AutoFAB-dev/Robot-Hardware/docs/README.md

# Docs

## Set up your cell
1. [What's in the box](setup/01-whats-in-the-box.md)
2. [Unbox and check for damage](setup/02-unboxing-and-damage-checks.md)
3. [Mount the arm and rail](setup/03-mounting-arm-and-rail.md)
4. [Wiring, power, stop and cameras](setup/04-wiring-power-stop-cameras.md)
5. [Flash, install, remote access](setup/05-flash-install-remote-access.md)
6. [Link your printer](setup/06-link-your-printer.md)
   Then [calibrate the cell](calibration/) (IDs are local; homing is after SSH, before the ready check)
7. [Ready check and handover](setup/07-ready-check-and-handover.md)

If something goes wrong: [Troubleshooting](troubleshooting.md) · [Getting help](getting-help.md)

## Calibration
[Index](calibration/) · [Servo IDs and homing](calibration/servo-ids-and-homing.md) · [Arm calibration files](calibration/arm-calibration-files.md) · [Rail homing](calibration/rail-homing.md) · [Cameras](calibration/cameras.md) · [Printer and bed](calibration/printer-and-bed.md)

## Reference
[Safety](reference/safety.md) · [Arm](reference/arm/) · [Rail](reference/rail/) · [Controller](reference/controller/) · [Cameras](reference/cameras/) · [printable files](../hardware/) · [all reference](reference/)
