AutoFAB-dev/Robot-Hardware/cad/README.md

# CAD and printable files

The full printable set now lives under [`hardware/`](../hardware/) (one folder per component, each with a part-by-part table).

| Folder | Contents | Licence |
|---|---|---|
| [`elrobot/`](elrobot/) | Earlier copies of the three ElRobot gripper camera-mount STLs and the basic 3MF | Apache-2.0, NormaCore |
| [`../hardware/arm/follower/`](../hardware/arm/follower/) | ElRobot follower STL / STEP / 3MF | Apache-2.0, NormaCore |
| [`../hardware/rail/`](../hardware/rail/) | leslider 3MF | Apache-2.0, Pham Tuan Binh |
| [`../hardware/controller/`](../hardware/controller/) | ElRobot driver enclosures | Apache-2.0, NormaCore |
| [`../hardware/cameras/`](../hardware/cameras/) | ElRobot gripper camera mounts | Apache-2.0, NormaCore |

- TODO: an AutoFAB base adapter that fits ElRobot on leslider's carriage (leslider's base mount is designed for the SO-101).
- TODO: calibration fiducial tile and holder files.
