AutoFAB-dev/Robot-Hardware/firmware/README.md

# Servo notes
Hardware-level IDs and wiring live with each component: [arm](../docs/reference/arm/), [rail](../docs/reference/rail/), [controller](../docs/reference/controller/), [cameras](../docs/reference/cameras/). Customer path: [step 4](../docs/setup/04-wiring-power-stop-cameras.md).
