AutoFAB-dev/Robot-Hardware/images/README.md

# Images
TODO: add photos and diagrams for each setup step:
- [ ] 01 parts laid out and labelled
- [ ] 02 open box, arm supported, damage checks
- [ ] 03 rail clamped next to a printer
- [ ] 04 wiring: stop, two supplies, hub, cameras
- [ ] 05 setup Wi-Fi and claim screen
- [ ] 06 printer added in the app
- [ ] 07 ready-check ticks
- [ ] DIY: arm build stages, pinion mesh, wrist-camera mount, driver enclosure

Licence: CC-BY-4.0 unless noted. Remove faces, serial numbers, network names and claim codes before committing.
