AutoFAB-dev/Robot-Hardware/hardware/arm/README.md

# Arm hardware

ElRobot **follower** only. Files and the part-by-part table: [follower/](follower/).

Upstream: https://github.com/norma-core/norma-core/tree/main/hardware/elrobot  
Commit: `0d17bb300d712eeb5437d41ddb95ce380b5384e6`  
Licence: Apache-2.0 ([follower/LICENSE](follower/LICENSE)). Copyright NormaCore.

Docs: [arm reference](../../docs/reference/arm/).
