AutoFAB-dev/Robot-Hardware/hardware/rail/README.md

# Rail hardware

leslider printed parts used on this cell. Unmodified copies from [leslider / Pham Tuan Binh](https://github.com/pham-tuan-binh/leslider) (Apache-2.0). Upstream file names are unchanged.

- **Upstream commit:** `a7c5c86669f7452e60e764f14ab0bff406213e3d`
- **Licence:** [LICENSE](LICENSE) (Apache-2.0). Copyright Pham Tuan Binh.

Print defaults: **TODO**. leslider does not state filament, nozzle, layer height, infill, or orientation. Do not assume the ElRobot PLA / 0.4 mm / 0.2 mm defaults.

Onshape source is linked from the [leslider README](https://github.com/pham-tuan-binh/leslider#2-3d-printed-parts). The `3d/onshape.png` preview is not a part file and is not copied.

The ElRobot-to-carriage adapter is AutoFAB and is **TODO**.

Docs: [rail reference](../../docs/reference/rail/).

## Printed parts

| File | Qty | Material | Print settings | Notes |
|---|---|---|---|---|
| [3d/separate_components/leg.3mf](3d/separate_components/leg.3mf) | 2 | TODO | TODO | One at each end of the 2020 |
| [3d/separate_components/base_mount.3mf](3d/separate_components/base_mount.3mf) | 1 | TODO | TODO | Designed for the SO-101 base, not ElRobot |
| [3d/separate_components/pinion.3mf](3d/separate_components/pinion.3mf) | 1 | TODO | TODO | Press-fits on the rail servo output gear |
| [3d/separate_components/track.3mf](3d/separate_components/track.3mf) | as needed | TODO | TODO | 20 mm rack segments; print enough to span the extrusion and trim the last if it overruns |
| [3d/full_print.3mf](3d/full_print.3mf) | 1 plate | TODO | TODO | All-in-one plate (legs, base mount, pinion, track) |
| ElRobot-to-carriage adapter | 1 | TODO | TODO | File **TODO** |
