AutoFAB-dev/Robot-Hardware/cad/elrobot/README.md

# ElRobot files (third-party)
These files are unmodified copies from the ElRobot follower arm by NormaCore:
https://github.com/norma-core/norma-core/tree/main/hardware/elrobot
They're licensed under **Apache-2.0** (see `LICENSE` in this folder). Copyright NormaCore.

The full follower set, including these same camera-mount files, is now in [`hardware/`](../../hardware/). This folder keeps the earlier copies.

| File | Upstream path |
|---|---|
| stl/CameraMount_square_27mm.stl, _34mm, _regular | hardware/elrobot/STL/gripper_camera_mounts/ |
| 3mf/gripper_camera_mounts_basic.3mf | hardware/elrobot/print/basic/ |

Printed-part lists: [arm parts](../../docs/reference/arm/parts.md), [cameras parts](../../docs/reference/cameras/parts.md).
