AutoFAB-dev/Robot-Hardware/docs/reference/arm/README.md

# Arm

ElRobot follower: seven joints plus a gripper. Reach **430 mm**, **7+1 DOF**, from the ElRobot README.

Credit: [ElRobot](https://github.com/norma-core/norma-core/tree/main/hardware/elrobot) by NormaCore (Apache-2.0), including the [follower assembly manual](https://github.com/norma-core/norma-core/blob/main/hardware/elrobot/manual-follower.pdf). Values not stated there are **TODO**.

Same pages as the other components:

- [Parts](parts.md)
- [Wiring and IDs](wiring.md) · [IDs](ids.md)
- [Assembly](assembly.md)
- [Checks](checks.md)

See also: [rail](../rail/), [controller](../controller/), [cameras](../cameras/). Customer path: [Set up your cell](../../setup/01-whats-in-the-box.md).
