AutoFAB-dev/Robot-Hardware/docs/reference/cameras/README.md

# Cameras

Wrist camera on the gripper, scene camera on the cell, and their mounts. The powered USB hub sits here because ElRobot requires it **primarily for the cameras**.

Credit: wrist camera, three gripper mounts, and hub notes from [ElRobot](https://github.com/norma-core/norma-core/tree/main/hardware/elrobot) by NormaCore (Apache-2.0), including the [follower assembly manual](https://github.com/norma-core/norma-core/blob/main/hardware/elrobot/manual-follower.pdf) steps 65–75 and the README “Camera Mounts” / “USB Hub & Power Distribution” sections. Scene camera examples from the ElRobot BOM (“Table Camera”) and the [cell parts list](../../../bom/BOM.md). Files: [hardware/cameras/](../../../hardware/cameras/). Values not stated there are **TODO**.

Same pages as the other components:

- [Parts](parts.md)
- [Wiring and IDs](wiring.md) · [IDs](ids.md)
- [Assembly](assembly.md)
- [Checks](checks.md)

See also: [arm](../arm/), [rail](../rail/), [controller](../controller/). Customer path: [Set up your cell](../../setup/01-whats-in-the-box.md).
