AutoFAB-dev/Robot-Hardware/docs/reference/controller/README.md

# Controller

Raspberry Pi, servo bus adapter, power supplies, and the physical stop. This is the box that powers the arm and rail buses and runs the closed AutoFAB image.

Credit: driver, 12 V barrel, and USB-is-data-only notes from the ElRobot [README](https://github.com/norma-core/norma-core/blob/main/hardware/elrobot/README.md) (BOM and “Hardware & Design Notes”) and the [follower assembly manual](https://github.com/norma-core/norma-core/blob/main/hardware/elrobot/manual-follower.pdf) (step 2 enclosure, steps 3–4 ID setup). Pi model and 27 W USB-C from the [cell parts list](../../../bom/BOM.md). Raspberry Pi power: [Raspberry Pi documentation](https://www.raspberrypi.com/documentation/). Values not stated there are **TODO**.

Same pages as the other components:

- [Parts](parts.md)
- [Wiring and IDs](wiring.md) · [IDs](ids.md)
- [Assembly](assembly.md)
- [Checks](checks.md)

See also: [arm](../arm/), [rail](../rail/), [cameras](../cameras/). Customer path: [Set up your cell](../../setup/01-whats-in-the-box.md).
