AutoFAB-dev/Robot-Hardware/docs/reference/rail/README.md

# Rail

leslider-style 2020 V-slot rack rail, plus the adapter that puts the ElRobot base on the carriage.

Credit: [leslider](https://github.com/pham-tuan-binh/leslider) by Pham Tuan Binh (Apache-2.0), including the [BOM, printed parts, and assembly](https://github.com/pham-tuan-binh/leslider#1-bill-of-materials). The ElRobot-to-carriage adapter is AutoFAB and is **TODO**. Values not stated upstream are **TODO**.

Same pages as the other components:

- [Parts](parts.md)
- [Wiring and IDs](wiring.md) · [IDs](ids.md)
- [Assembly](assembly.md)
- [Checks](checks.md)

See also: [arm](../arm/), [controller](../controller/), [cameras](../cameras/). Customer path: [Set up your cell](../../setup/01-whats-in-the-box.md).
