AutoFAB-dev/Robot-Hardware/docs/getting-help.md

# Getting help

This repo is the self-service guide for putting the cell next to your printers and handing it to AutoFAB. AutoFAB software is closed source.

**Safety:** If the stop fails or the arm moves when it should not, unplug 12 V and [report it privately](../SECURITY.md). That is a safety issue, not a public bug thread.

## AutoFAB (the service)
For the managed service or a setup password, email [info@autofab.net](mailto:info@autofab.net).

## This hardware guide
- Walk the numbered path from [Set up your cell](setup/01-whats-in-the-box.md).
- Check [Troubleshooting](troubleshooting.md).
- Open a GitHub **issue** if a step in this guide is wrong. Never post passwords, setup-card details, claim codes, tokens, or photos that show them.

## Security and conduct
- Security: [SECURITY.md](../SECURITY.md)
- Conduct: [CODE_OF_CONDUCT.md](../CODE_OF_CONDUCT.md)
