AutoFAB-dev/Robot-Hardware/docs/reference/arm/checks.md

# Arm — checks

Credit: rotation and seating notes from the ElRobot follower manual (full rotation after each horn; jaws even; footprints clean).

**TODO image:** arm supported, every joint moved by hand, gripper jaws even

With **12 V off**:

- [ ] Each servo 1–8 is labelled and matches [IDs](ids.md)
- [ ] Every joint turns through the range the manual calls “full rotation”
- [ ] Gripper jaws move evenly; gear is fully seated
- [ ] No cable snags; slack at every joint
- [ ] Shields do not bind the joints
- [ ] Arm is supported so it cannot slam down

Do not command motion from software for these checks. Powered checks are done with AutoFAB after handover.
