AutoFAB-dev/Robot-Hardware/docs/reference/arm/ids.md

# Arm — IDs

Credit: IDs **1–8** and “label each servo 1 to 8” from the ElRobot [follower assembly manual](https://github.com/norma-core/norma-core/blob/main/hardware/elrobot/manual-follower.pdf) (steps 3–4 and each joint).

Set IDs **one servo at a time**. Label each servo before you install it. **TODO:** ElRobot says “Set Servo ids using app” and does not name the app.

| ID | Where it goes (ElRobot manual) |
|---|---|
| 1 | Base |
| 2 | Joint 1 |
| 3 | Joint 2 |
| 4 | Joint 3 |
| 5 | Joint 4 |
| 6 | Joint 5 |
| 7 | Joint 6 |
| 8 | Gripper |

Rail drive is **ID 9**: [rail IDs](../rail/ids.md). Do not use leslider's SO-101 slider ID 7 on this arm.
