AutoFAB-dev/Robot-Hardware/docs/reference/rail/checks.md

# Rail — checks

Credit: carriage travel and pinion mesh from leslider assembly plus the customer mount step. Click / jump notes match [troubleshooting](../../troubleshooting.md).

**TODO image:** rail clamped, carriage rolled by hand the full length, pinion on the rack

With **12 V off**:

- [ ] Rail servo is labelled **9** and matches [IDs](ids.md) (not leslider’s SO-101 ID 7)
- [ ] Track segments sit in the top channel and span the extrusion
- [ ] Gantry V-wheels are in the side channels; the plate was fitted before the legs
- [ ] Both legs are bolted (M5 into drop-in T-nuts)
- [ ] Base mount is on the gantry (two M5, 20 mm spacing)
- [ ] ElRobot adapter is fitted — file and fasteners still **TODO**; do not leave the SO-101 base mount standing in for ElRobot
- [ ] Pinion is on the output gear and engaged with the rack
- [ ] Carriage rolls the full length by hand. If it clicks or jumps, the pinion is not meshed
- [ ] Bus cable is after the gripper; slack loop along the rail; no snags

Do not command motion from software for these checks. Powered checks are done with AutoFAB after handover.
