AutoFAB-dev/Robot-Hardware/hardware/rail/3d/full_print.3mf

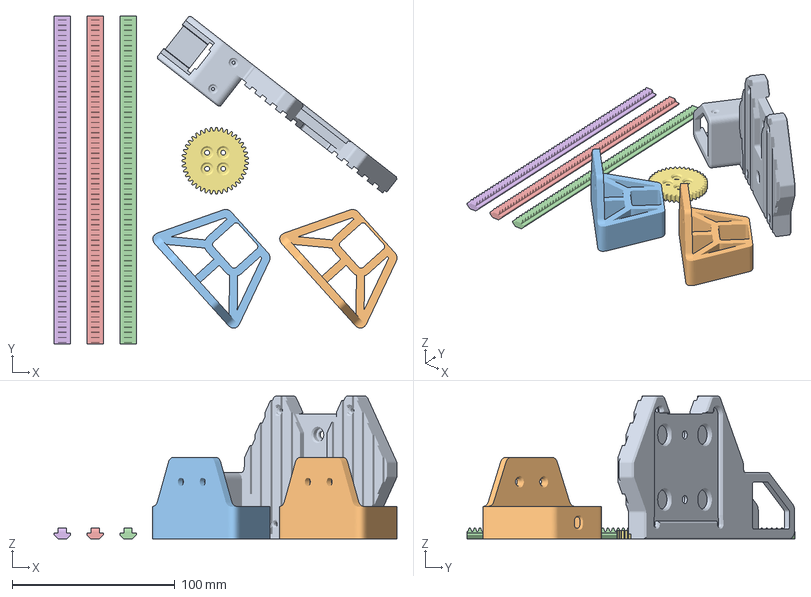
[picture p1: CAD file, 2026-10-17]
hardware/rail/3d/full_print.3mf
210.5 x 201.1 x 87.6 mm
Base Mount
Leg x 2
Track x 3
Pinion
