AutoFAB-dev/Robot-Hardware/cad/elrobot/3mf/gripper_camera_mounts_basic.3mf

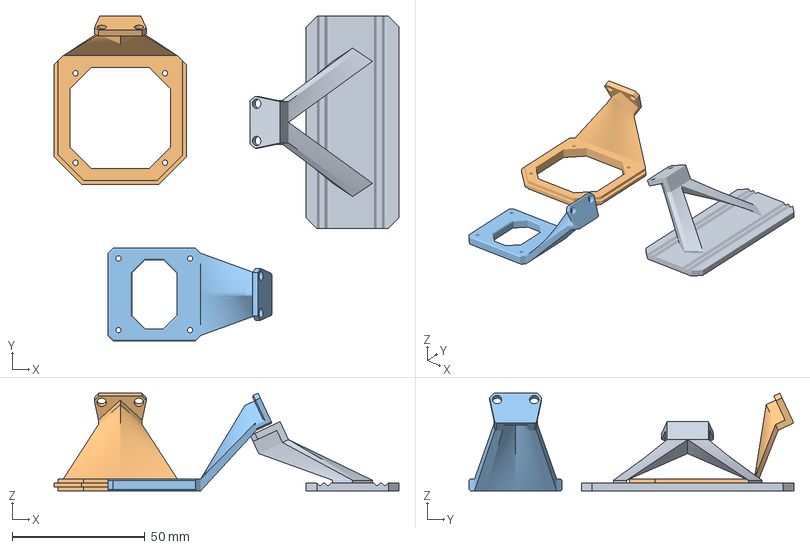
[picture p2: CAD file, 2026-10-17]
cad/elrobot/3mf/gripper_camera_mounts_basic.3mf
130.1 x 122.4 x 36.8 mm
CameraMount_regular.stl
CameraMount_square_34mm.stl
CameraMount_square_27mm.stl
