AutoFAB-dev/Robot-Hardware/cad/elrobot/stl/CameraMount_square_34mm.stl

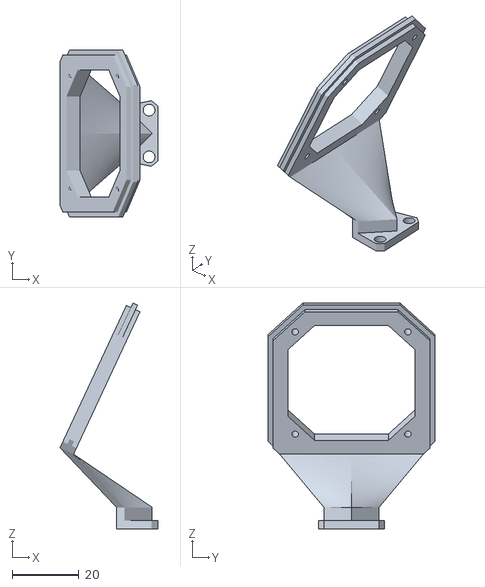
[picture p3: CAD file, 2026-10-17]
cad/elrobot/stl/CameraMount_square_34mm.stl
29.3 x 50.0 x 67.6
