AutoFAB-dev/Robot-Hardware/hardware/arm/follower/print/ams/elrobot_follower_ams.3mf

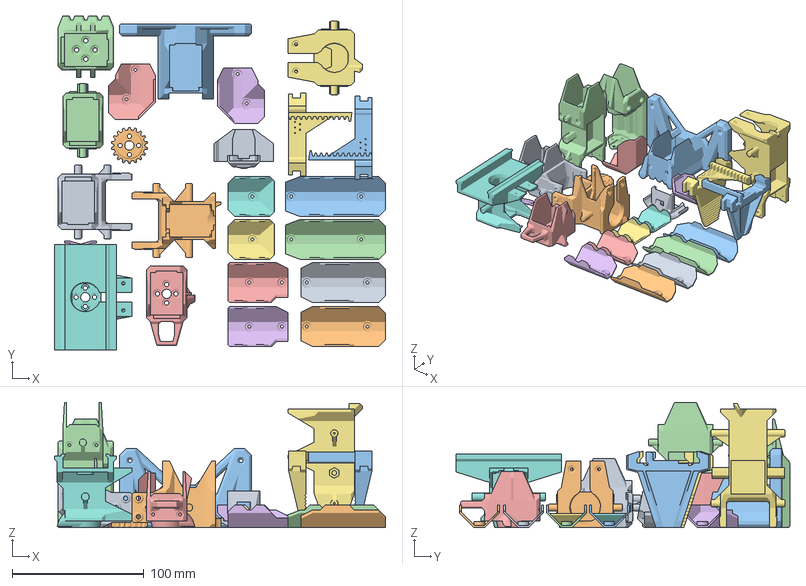
[picture p4: CAD file, 2026-10-17]
hardware/arm/follower/print/ams/elrobot_follower_ams.3mf
251.0 x 253.1 x 95.0 mm
Base Shield.stl
Gripper Gear.stl
Gripper Jaw.stl x 2
Joint 1.stl
Joint 5.stl
Wiring_bracket.stl
Gripper Base.stl
Joint 3.stl
Joint 6.stl
Base.stl
Joint_02.stl
Joint 3 Shield Drive Side.stl
Joint 3 Shield Camera Side.stl
Gripper Base Shield.stl x 2
Joint 2 Shield.stl x 2
Joint 4 Shield.stl x 2
Joint 6 Shield.stl x 2
Joint 4.stl
