AutoFAB-dev/Robot-Hardware/hardware/arm/follower/STEP/elrobot_common_parts/Joint 2.stp

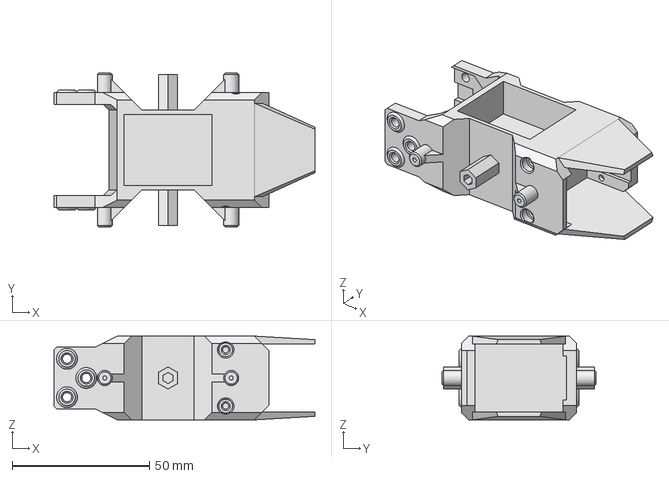
[picture p5: CAD file, 2026-10-17]
hardware/arm/follower/STEP/elrobot_common_parts/Joint 2.stp
95.0 x 56.0 x 30.5 mm
