AutoFAB-dev/Robot-Hardware/hardware/arm/follower/STEP/elrobot_follower_parts/Gripper.stp

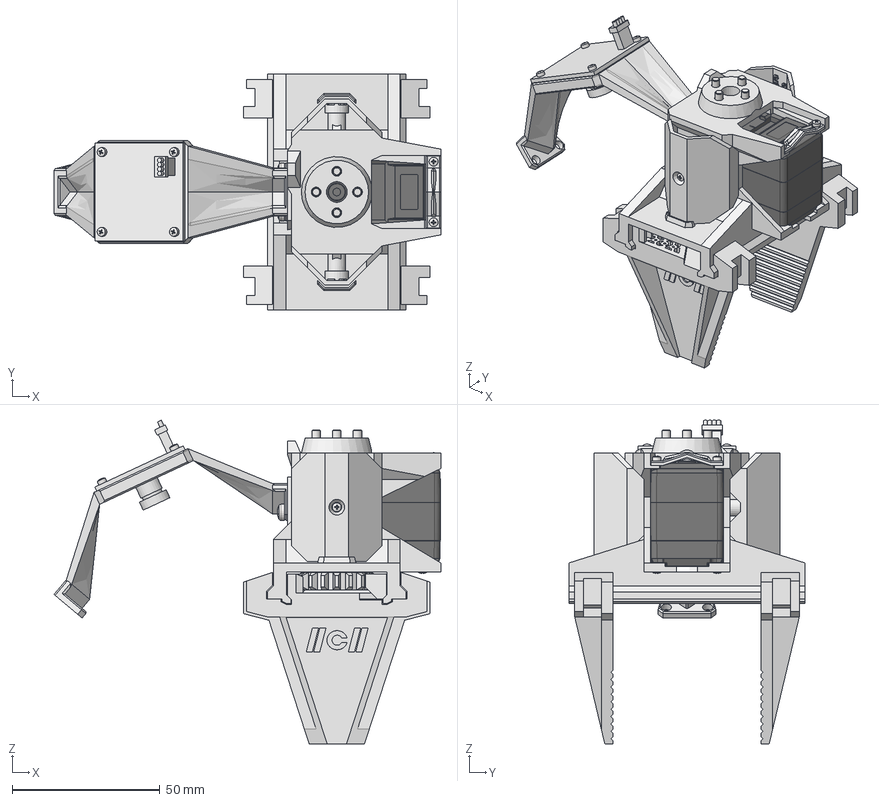
[picture p6: CAD file, 2026-10-17]
hardware/arm/follower/STEP/elrobot_follower_parts/Gripper.stp
130.9 x 80.0 x 109.5 mm
Gripper_Base
Gripper_Gear
Gripper_Jaw x 2
Gripper_Base_Shield_Drive_Side
Gripper_Base_Shield_Camera_Side
CameraMount_square32mm
Wiring_bracket
UVC_Camera
Idler Horn
ZK_122
SG-ZIJI_15
XG-ZIJI_16
MOTOR-1723_3
PCB-CHAZUO_92
GE_27
金属舵盘（驱动）
CRFHTSTATI ANSI B18.6.4 - 1-42 x 3/16 Steel Grade 2 Plain x 10
DIN EN ISO 7045 - M3 x 6 - H Steel 4.6 Plain x 11
