AutoFAB-dev/Robot-Hardware/hardware/arm/follower/STEP/elrobot_follower_parts/individual/Gripper_Base_Shield.stp

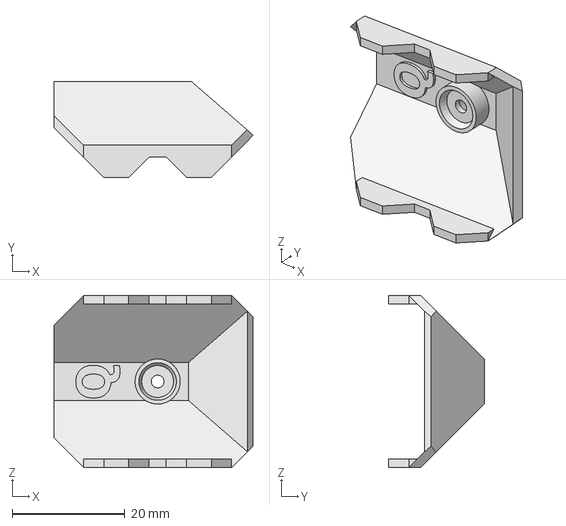
[picture p7: CAD file, 2026-10-17]
hardware/arm/follower/STEP/elrobot_follower_parts/individual/Gripper_Base_Shield.stp
35.3 x 17.0 x 30.5 mm
