AutoFAB-dev/Robot-Hardware/hardware/arm/follower/STL/elrobot_follower/panels.stl

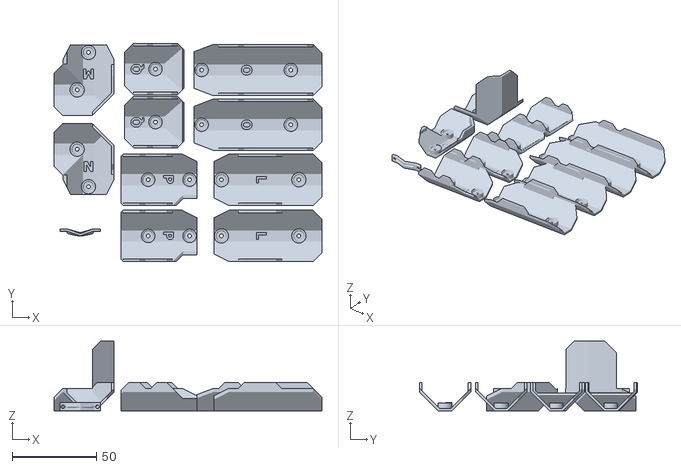
[picture p8: CAD file, 2026-10-17]
hardware/arm/follower/STL/elrobot_follower/panels.stl
159.2 x 129.6 x 41.5
