AutoFAB-dev/Robot-Hardware/hardware/arm/follower/STL/elrobot_individual_parts/elrobot_common_parts/Wiring_bracket.stl

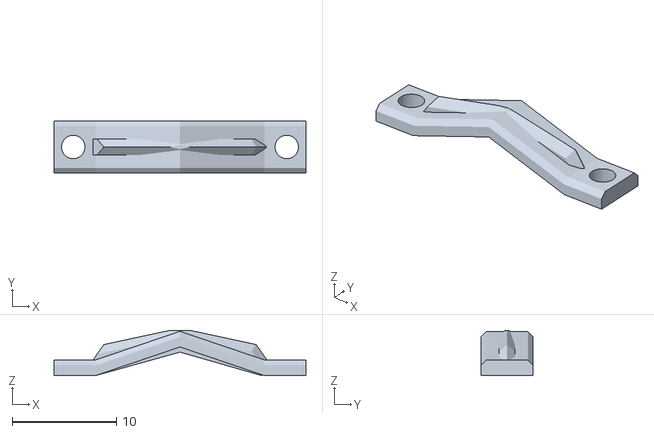
[picture p9: CAD file, 2026-10-17]
hardware/arm/follower/STL/elrobot_individual_parts/elrobot_common_parts/Wiring_bracket.stl
24.2 x 5.00 x 4.33
