AutoFAB-dev/Robot-Hardware/hardware/arm/follower/STL/elrobot_individual_parts/elrobot_follower_parts/Gripper Jaw.stl

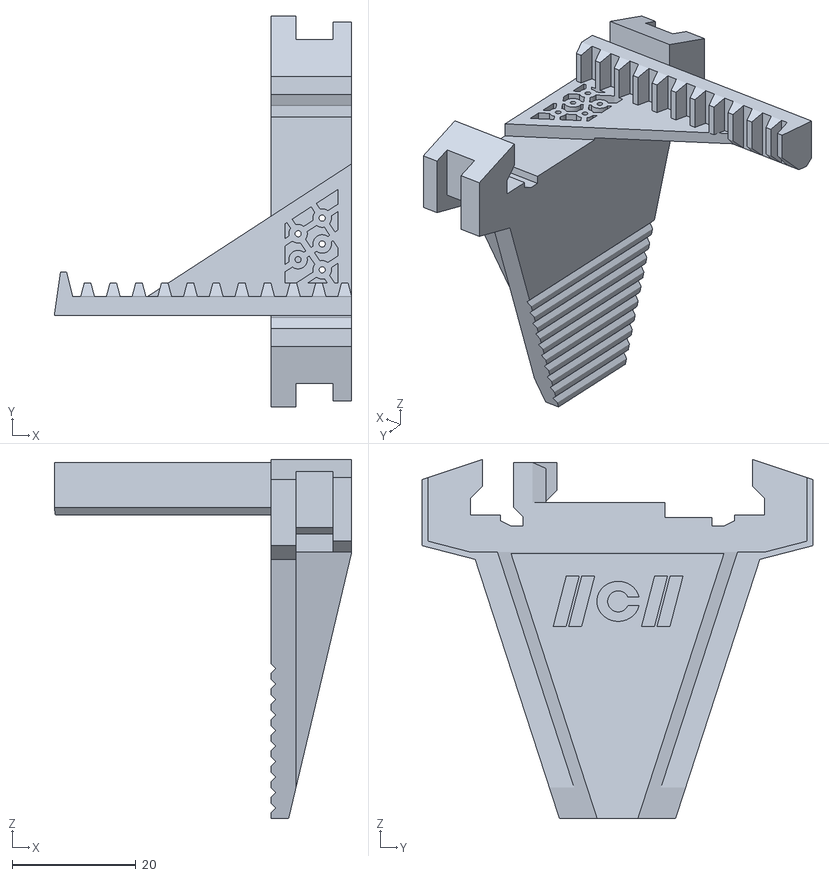
[picture p10: CAD file, 2026-10-17]
hardware/arm/follower/STL/elrobot_individual_parts/elrobot_follower_parts/Gripper Jaw.stl
48.0 x 63.1 x 58.0
