AutoFAB-dev/Robot-Hardware/hardware/controller/print/ams/enclosure_for_waveshare_ams.3mf

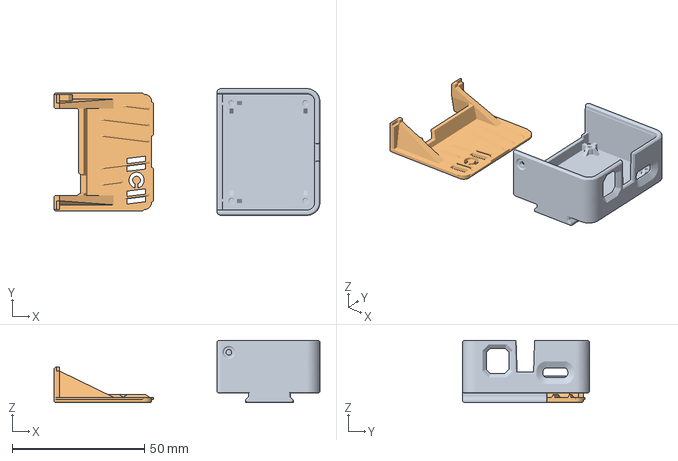
[picture p11: CAD file, 2026-10-17]
hardware/controller/print/ams/enclosure_for_waveshare_ams.3mf
100.7 x 48.0 x 23.5 mm
ws_enclosure_case.stl
ws_enclosure_lid.stl
