AutoFAB-dev/Robot-Hardware/hardware/controller/STEP/case_for_seedstudio/ss_enclosure_case.stp

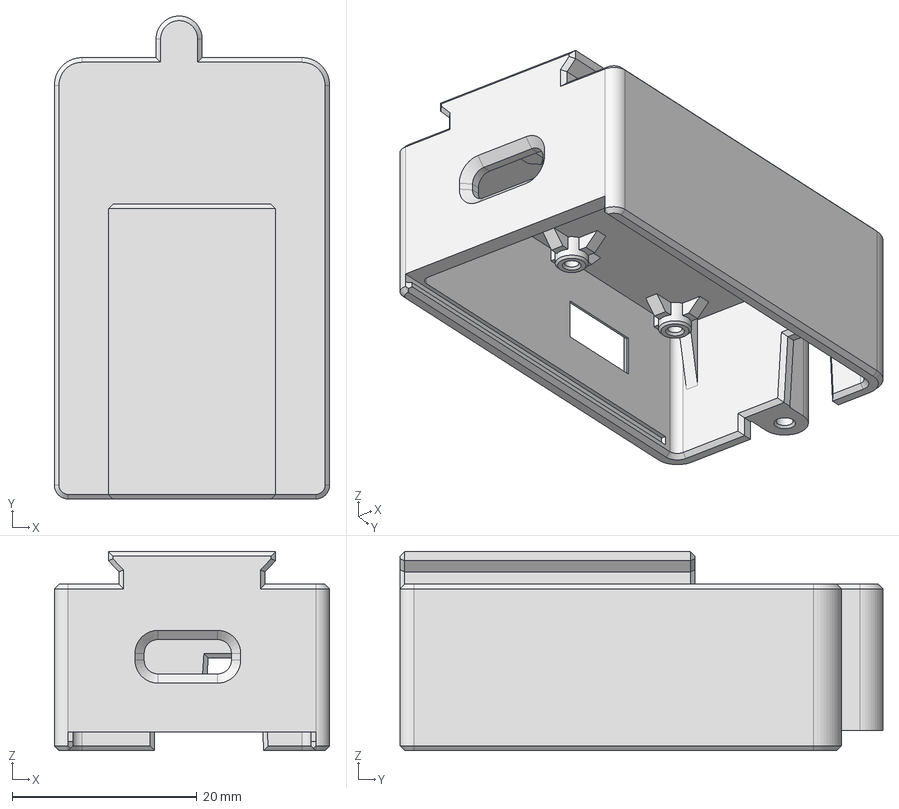
[picture p12: CAD file, 2026-10-17]
hardware/controller/STEP/case_for_seedstudio/ss_enclosure_case.stp
29.8 x 52.3 x 21.5 mm
