AutoFAB-dev/Robot-Hardware/hardware/controller/STEP/case_for_waveshare/ws_enclosure_case.stp

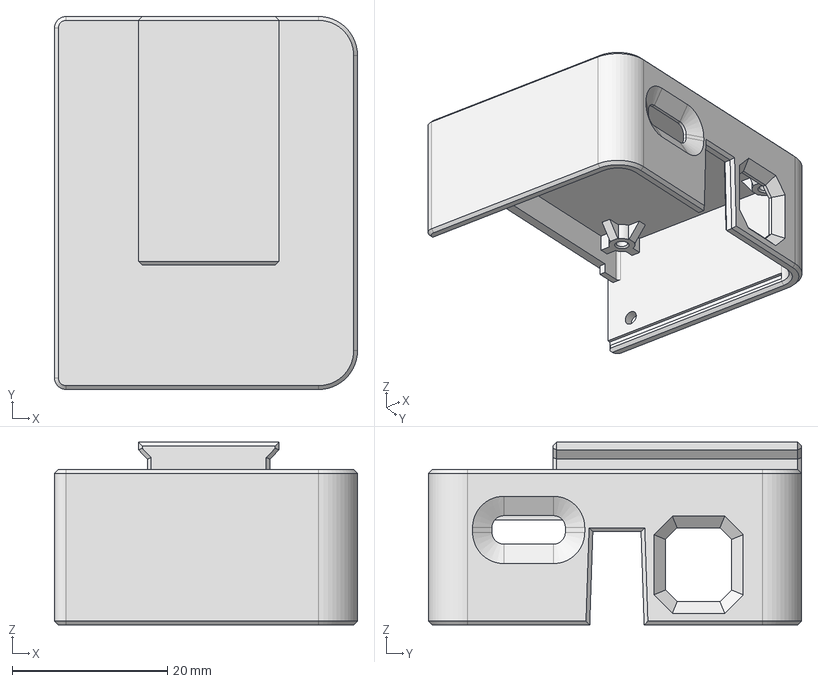
[picture p13: CAD file, 2026-10-17]
hardware/controller/STEP/case_for_waveshare/ws_enclosure_case.stp
39.0 x 48.0 x 23.5 mm
