AutoFAB-dev/Robot-Hardware/hardware/rail/3d/separate_components/track.3mf

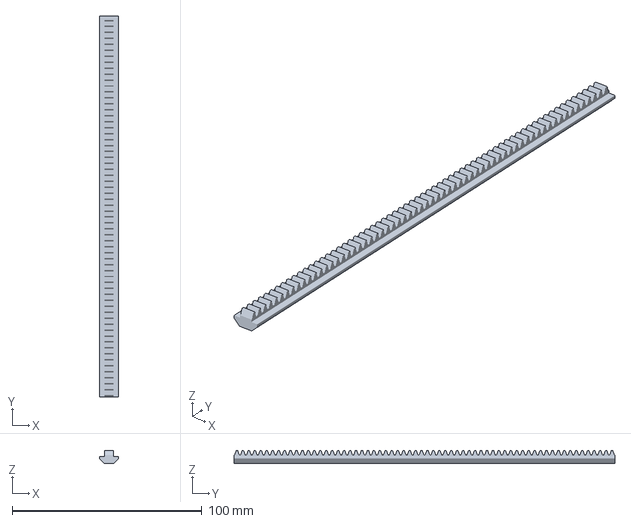
[picture p14: CAD file, 2026-10-17]
hardware/rail/3d/separate_components/track.3mf
10.2 x 201.1 x 6.66 mm
