AutoFAB-dev/Robot-Hardware/cad/elrobot/stl/CameraMount_square_27mm.stl

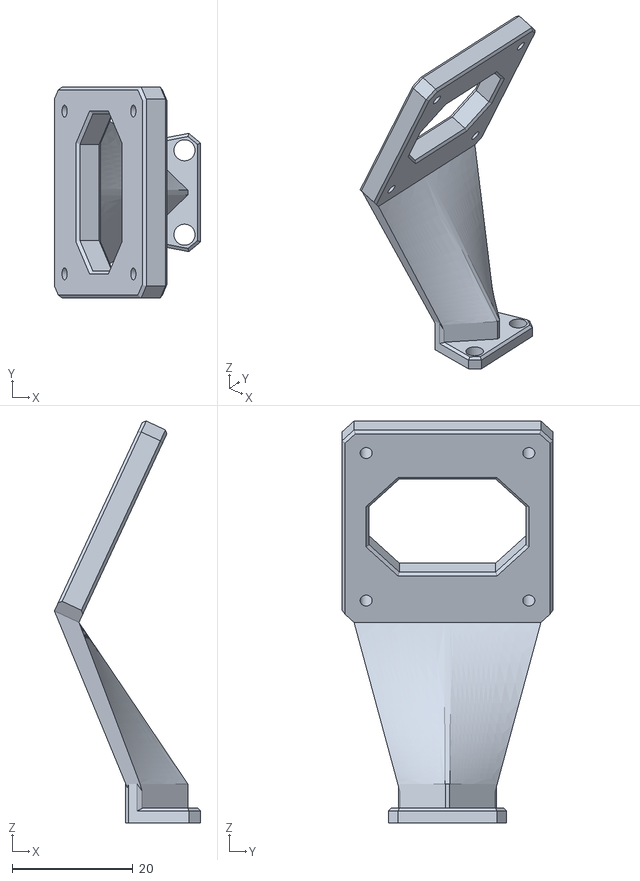
[picture p15: CAD file, 2026-10-17]
cad/elrobot/stl/CameraMount_square_27mm.stl
24.3 x 35.0 x 66.7
