AutoFAB-dev/Robot-Hardware/hardware/arm/follower/STL/elrobot_follower/regular_parts.stl

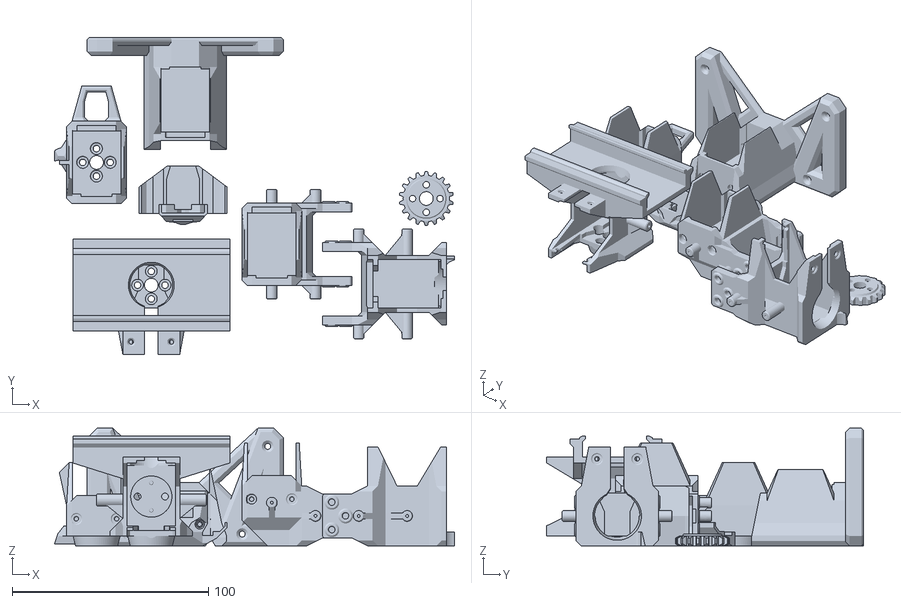
[picture p16: CAD file, 2026-10-17]
hardware/arm/follower/STL/elrobot_follower/regular_parts.stl
203.8 x 161.3 x 60.0
