AutoFAB-dev/Robot-Hardware/hardware/arm/follower/STL/elrobot_individual_parts/elrobot_common_parts/Joint 3 Shield Camera Side.stl

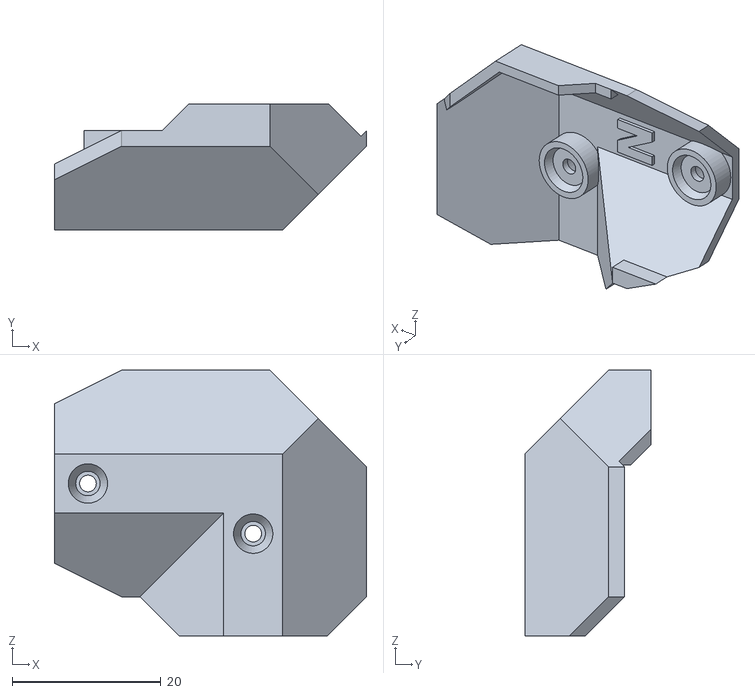
[picture p17: CAD file, 2026-10-17]
hardware/arm/follower/STL/elrobot_individual_parts/elrobot_common_parts/Joint 3 Shield Camera Side.stl
42.0 x 17.0 x 35.7
