AutoFAB-dev/Robot-Hardware/hardware/cameras/STEP/gripper_camera_mounts/CameraMount_regular.stp

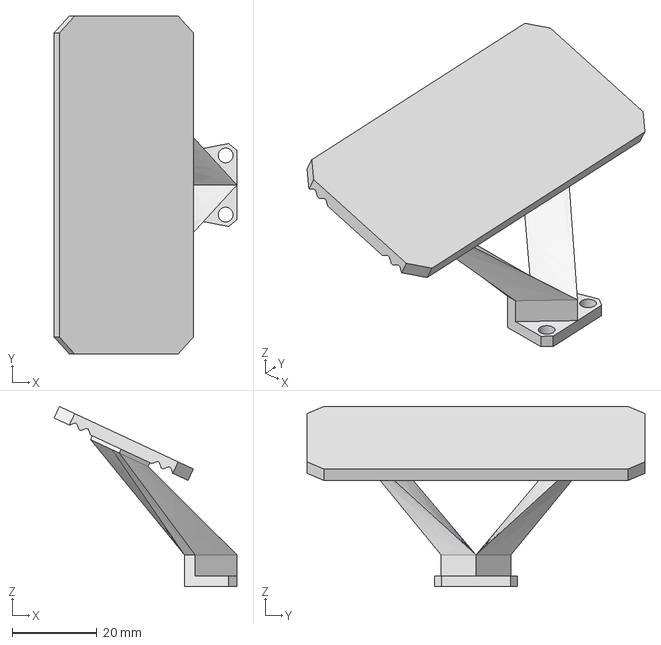
[picture p18: CAD file, 2026-10-17]
hardware/cameras/STEP/gripper_camera_mounts/CameraMount_regular.stp
43.3 x 80.0 x 42.6 mm
