AutoFAB-dev/Robot-Hardware/hardware/controller/print/ams/enclosure_for_seedstudio_ams.3mf

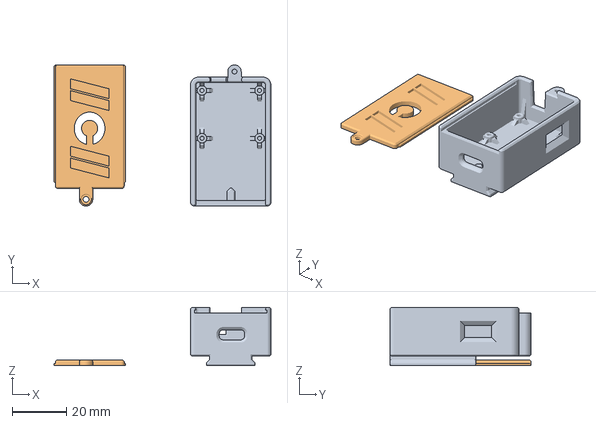
[picture p19: CAD file, 2026-10-17]
hardware/controller/print/ams/enclosure_for_seedstudio_ams.3mf
80.3 x 52.3 x 21.5 mm
ss_enclosure_case.stl
ss_enclosure_lid.stl
