AutoFAB-dev/Robot-Hardware/hardware/controller/STEP/case_for_seedstudio/ss_enclosure_lid.stp

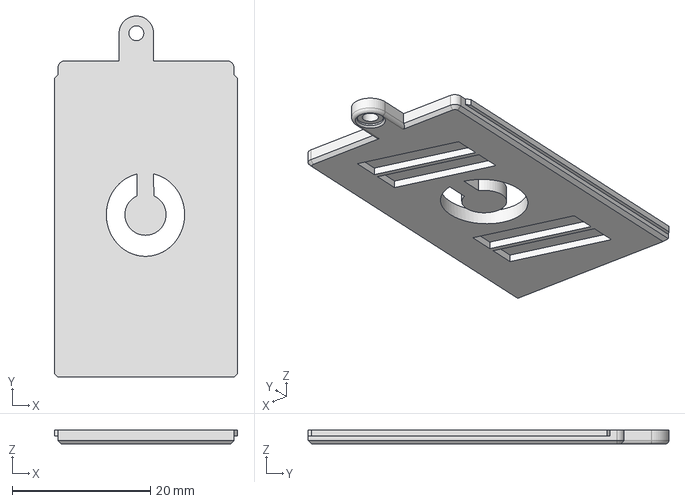
[picture p20: CAD file, 2026-10-17]
hardware/controller/STEP/case_for_seedstudio/ss_enclosure_lid.stp
26.5 x 52.3 x 2.00 mm
