AutoFAB-dev/Robot-Hardware/hardware/controller/STEP/case_for_waveshare/ws_enclosure_lid.stp

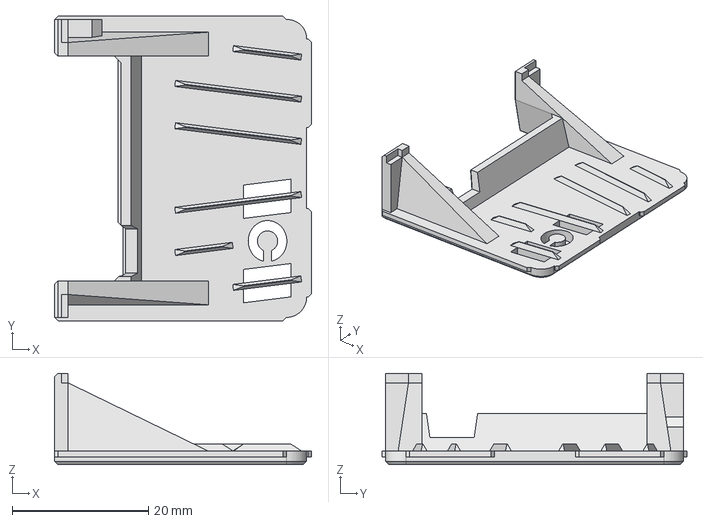
[picture p21: CAD file, 2026-10-17]
hardware/controller/STEP/case_for_waveshare/ws_enclosure_lid.stp
37.7 x 44.7 x 13.4 mm
