AutoFAB-dev/Robot-Hardware/hardware/rail/3d/separate_components/leg.3mf

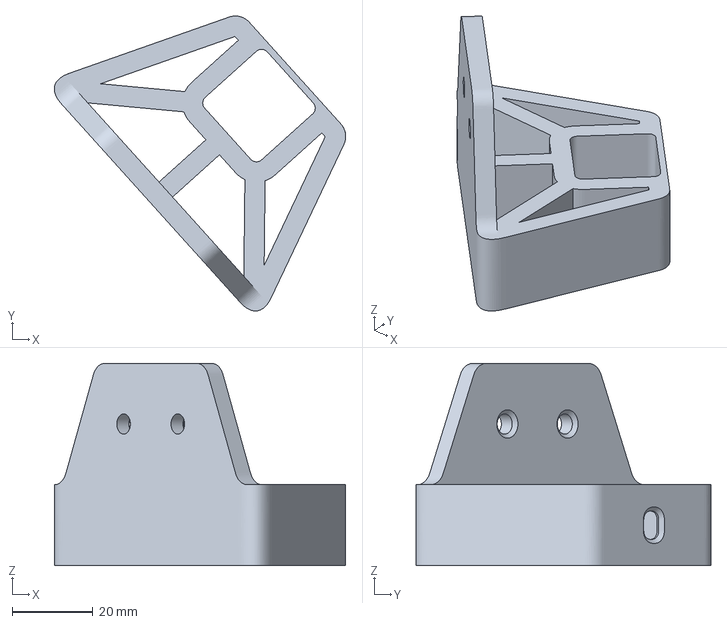
[picture p22: CAD file, 2026-10-17]
hardware/rail/3d/separate_components/leg.3mf
72.0 x 72.9 x 50.0 mm
