AutoFAB-dev/Robot-Hardware/hardware/arm/follower/STEP/elrobot_common_parts/Joint 6.stp

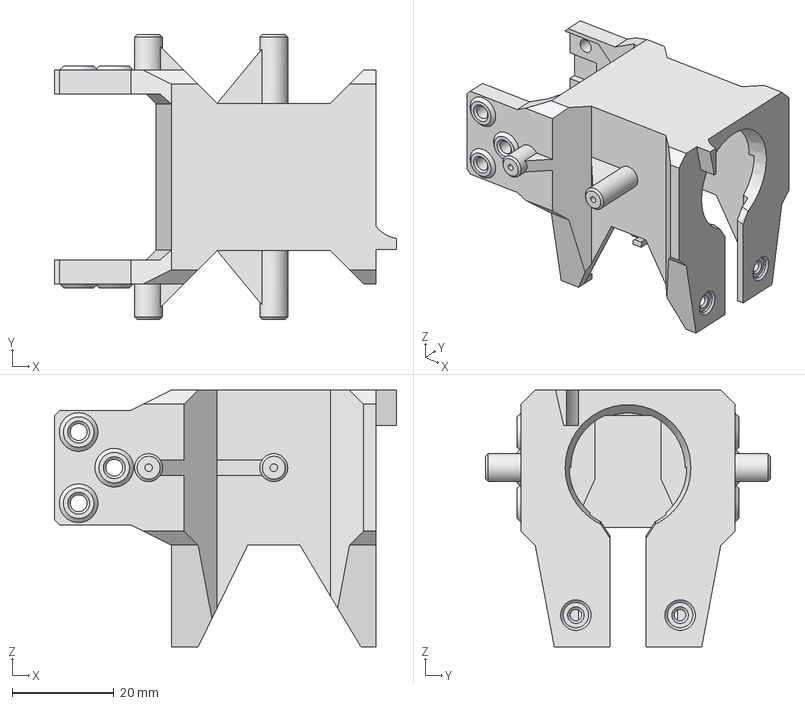
[picture p23: CAD file, 2026-10-17]
hardware/arm/follower/STEP/elrobot_common_parts/Joint 6.stp
67.2 x 56.0 x 50.5 mm
