AutoFAB-dev/Robot-Hardware/hardware/arm/follower/STEP/elrobot_follower_parts/individual/Gripper_Base.stp

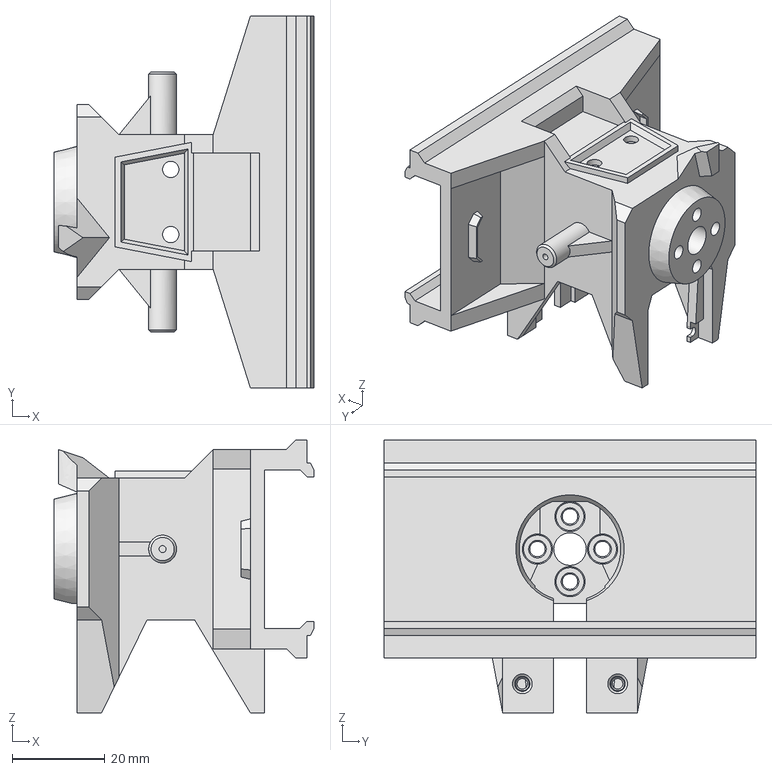
[picture p24: CAD file, 2026-10-17]
hardware/arm/follower/STEP/elrobot_follower_parts/individual/Gripper_Base.stp
56.0 x 80.0 x 58.7 mm
