AutoFAB-dev/Robot-Hardware/hardware/arm/follower/STL/elrobot_follower/strong_parts.stl

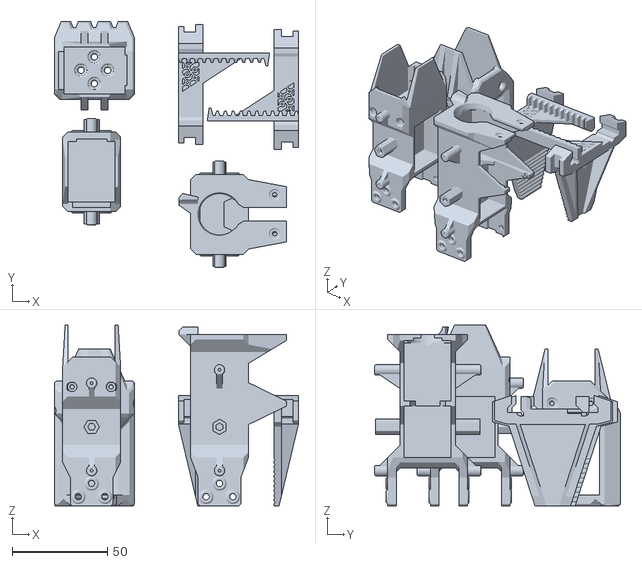
[picture p25: CAD file, 2026-10-17]
hardware/arm/follower/STL/elrobot_follower/strong_parts.stl
128.3 x 129.4 x 95.0
