AutoFAB-dev/Robot-Hardware/hardware/arm/follower/STL/elrobot_individual_parts/elrobot_common_parts/Base Shield.stl

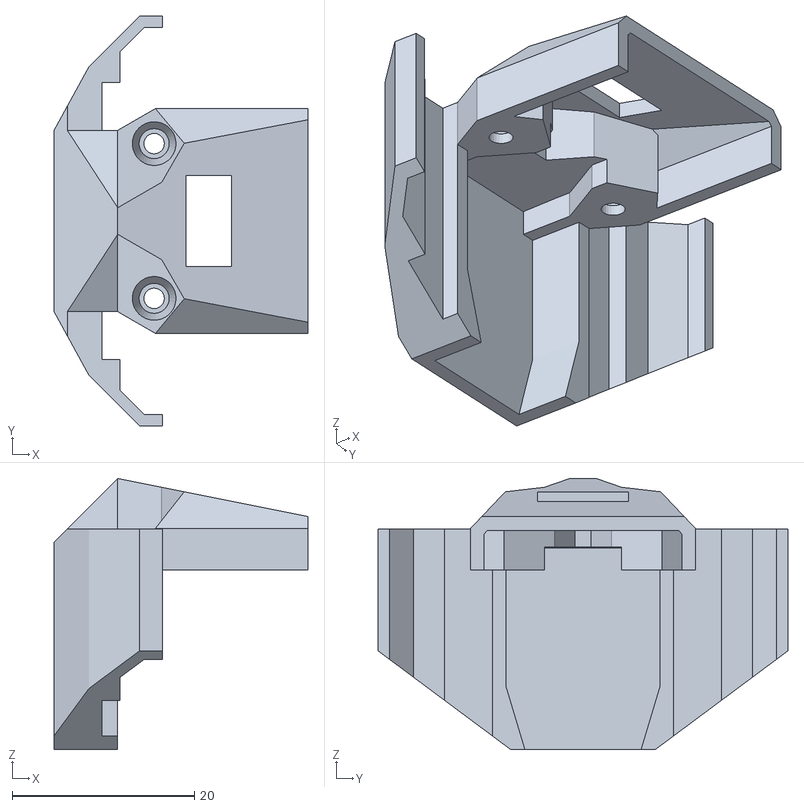
[picture p26: CAD file, 2026-10-17]
hardware/arm/follower/STL/elrobot_individual_parts/elrobot_common_parts/Base Shield.stl
27.9 x 45.0 x 29.8
