AutoFAB-dev/Robot-Hardware/hardware/rail/3d/separate_components/pinion.3mf

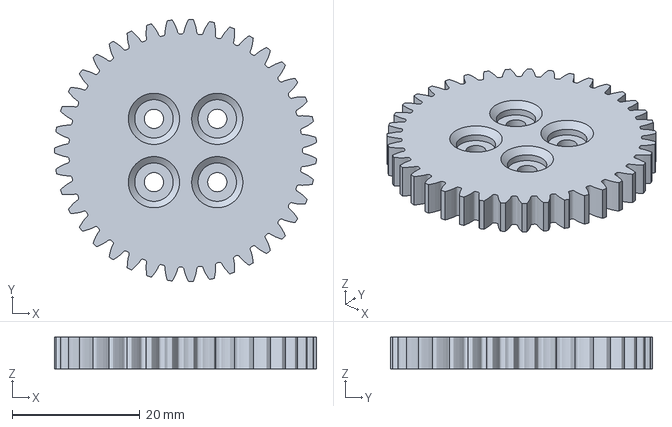
[picture p27: CAD file, 2026-10-17]
hardware/rail/3d/separate_components/pinion.3mf
41.0 x 41.0 x 5.00 mm
