AutoFAB-dev/Robot-Hardware/hardware/arm/follower/STEP/elrobot_common_parts/Joint 3 Shield Drive Side.stp

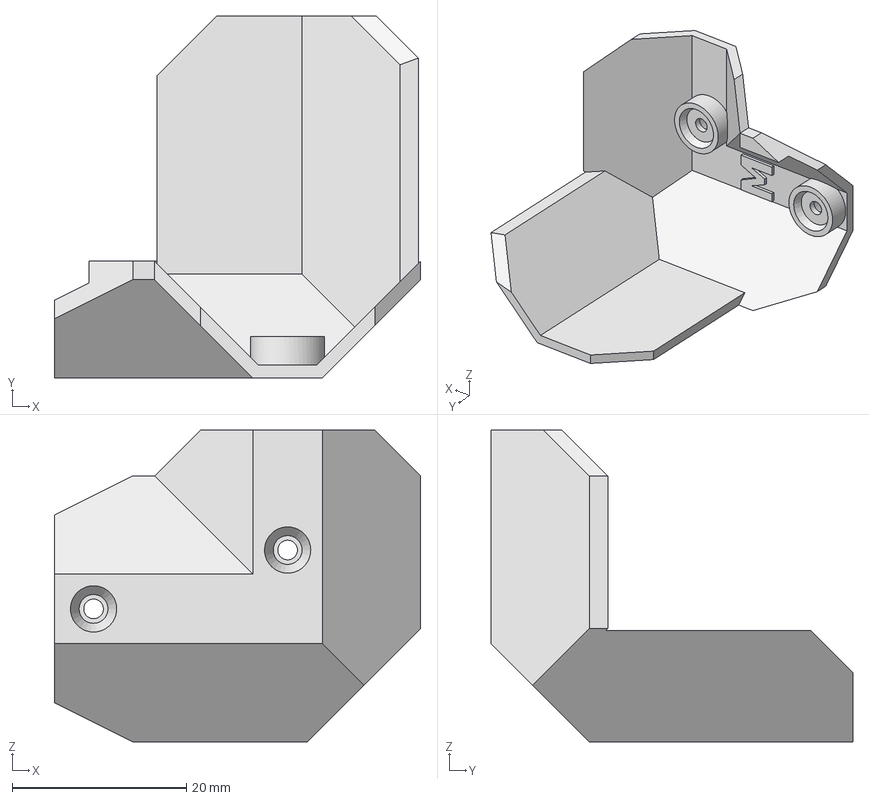
[picture p28: CAD file, 2026-10-17]
hardware/arm/follower/STEP/elrobot_common_parts/Joint 3 Shield Drive Side.stp
42.0 x 41.5 x 35.8 mm
