AutoFAB-dev/Robot-Hardware/hardware/arm/follower/STEP/elrobot_follower_parts/individual/Gripper_Gear.stp

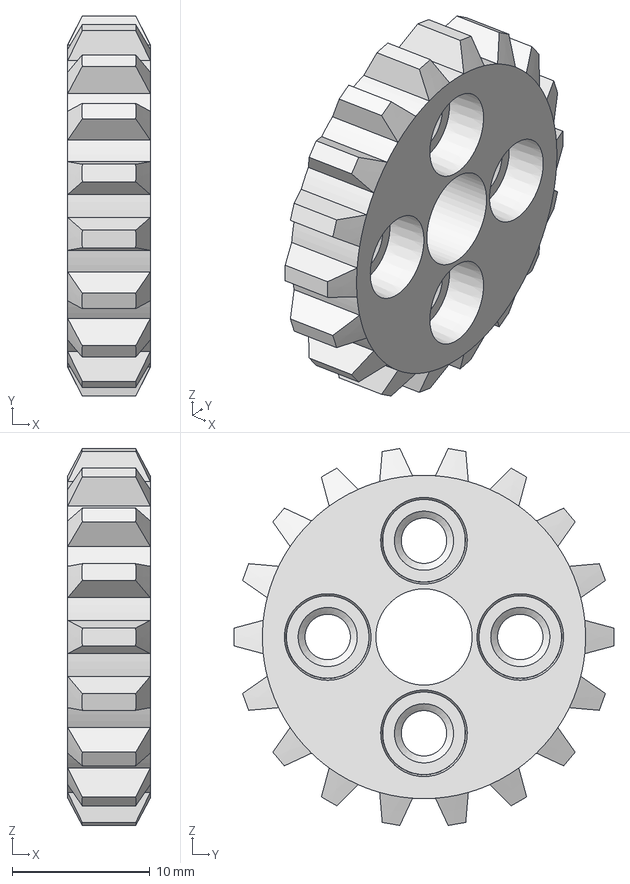
[picture p29: CAD file, 2026-10-17]
hardware/arm/follower/STEP/elrobot_follower_parts/individual/Gripper_Gear.stp
6.00 x 27.6 x 27.4 mm
