AutoFAB-dev/Robot-Hardware/hardware/arm/follower/STL/elrobot_individual_parts/elrobot_common_parts/Joint 5.stl

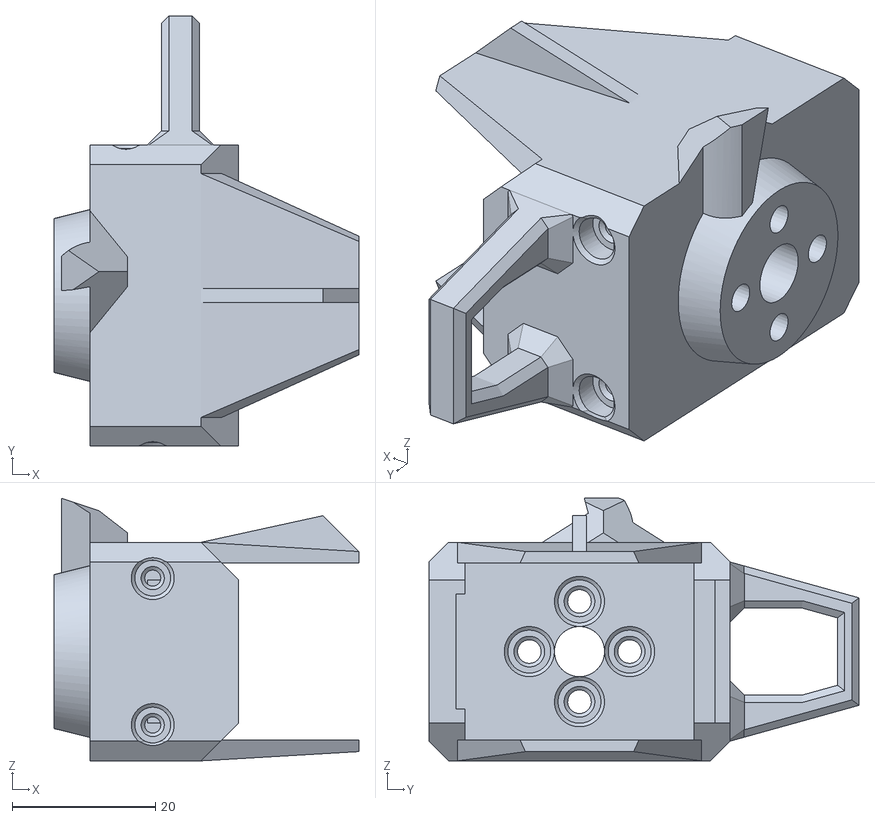
[picture p30: CAD file, 2026-10-17]
hardware/arm/follower/STL/elrobot_individual_parts/elrobot_common_parts/Joint 5.stl
42.5 x 60.0 x 36.7
