AutoFAB-dev/Robot-Hardware/hardware/arm/follower/STL/elrobot_individual_parts/elrobot_follower_parts/Gripper Gear.stl

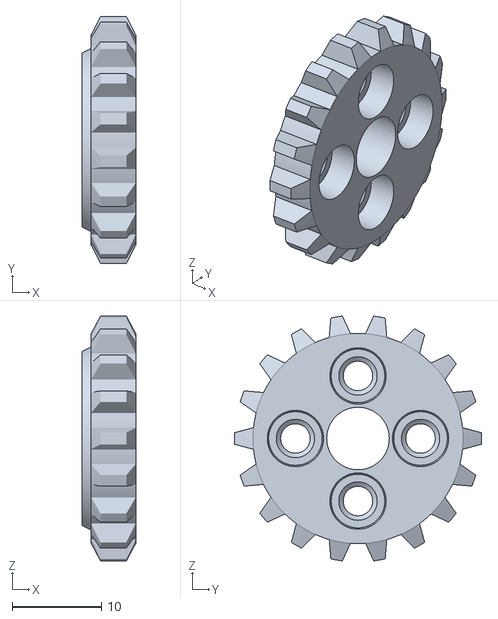
[picture p31: CAD file, 2026-10-17]
hardware/arm/follower/STL/elrobot_individual_parts/elrobot_follower_parts/Gripper Gear.stl
6.00 x 27.6 x 27.4
