AutoFAB-dev/Robot-Hardware/hardware/rail/3d/separate_components/base_mount.3mf

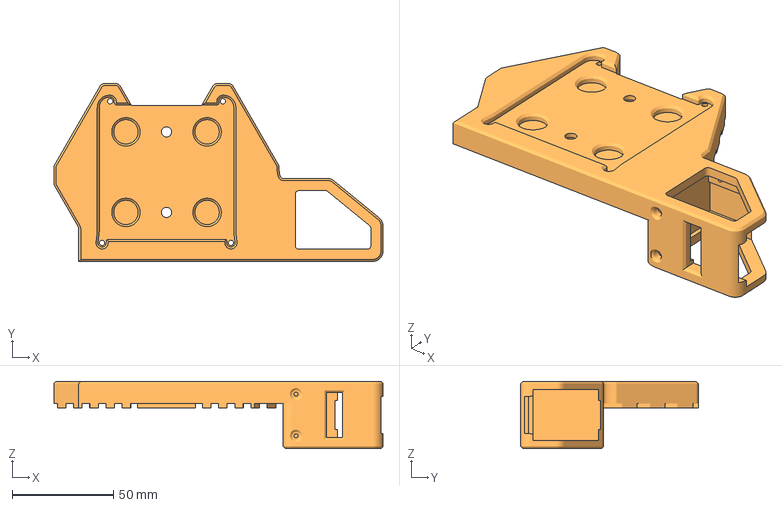
[picture p32: CAD file, 2026-10-17]
hardware/rail/3d/separate_components/base_mount.3mf
162.1 x 87.6 x 33.1 mm
