AutoFAB-dev/Robot-Hardware/hardware/arm/follower/STL/elrobot_individual_parts/elrobot_common_parts/Joint 4 Shield.stl

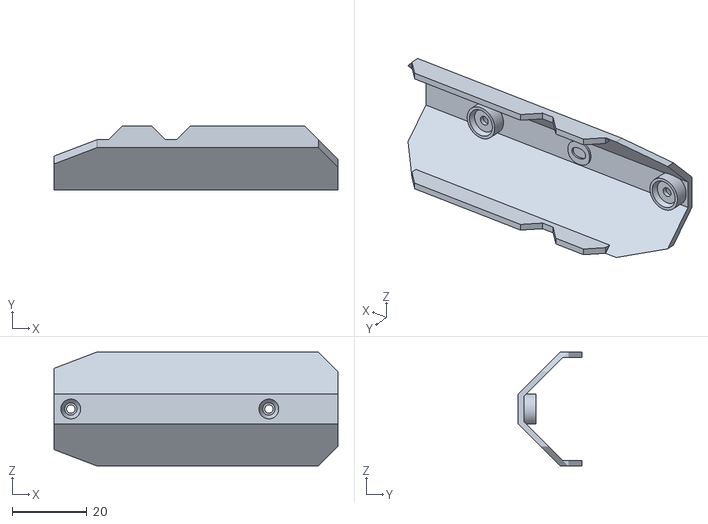
[picture p33: CAD file, 2026-10-17]
hardware/arm/follower/STL/elrobot_individual_parts/elrobot_common_parts/Joint 4 Shield.stl
76.0 x 17.0 x 30.5
