AutoFAB-dev/Robot-Hardware/hardware/arm/follower/STEP/elrobot_common_parts/Joint 1.stp

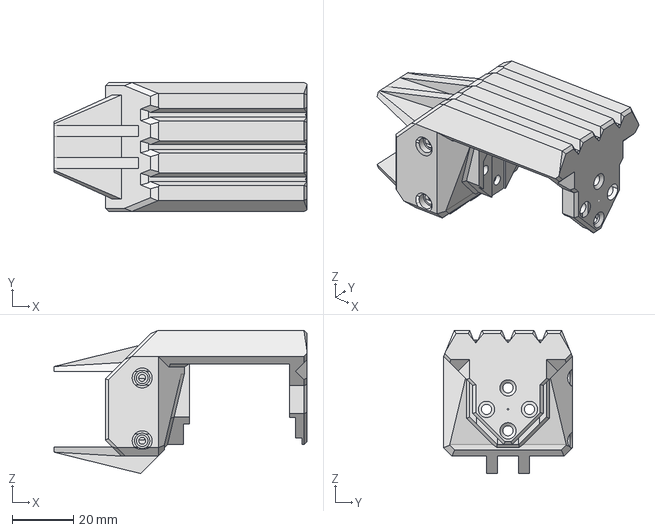
[picture p34: CAD file, 2026-10-17]
hardware/arm/follower/STEP/elrobot_common_parts/Joint 1.stp
82.5 x 42.0 x 46.7 mm
