AutoFAB-dev/Robot-Hardware/hardware/arm/follower/STL/elrobot_individual_parts/elrobot_common_parts/Joint 6 Shield.stl

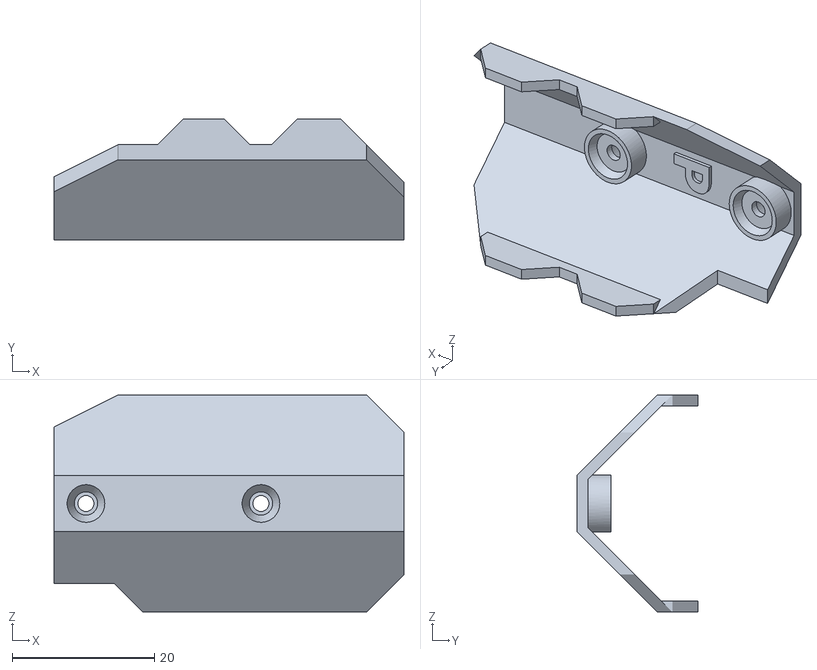
[picture p35: CAD file, 2026-10-17]
hardware/arm/follower/STL/elrobot_individual_parts/elrobot_common_parts/Joint 6 Shield.stl
49.2 x 17.0 x 30.5
