AutoFAB-dev/Robot-Hardware/hardware/arm/follower/STEP/elrobot_common_parts/Joint 4.stp

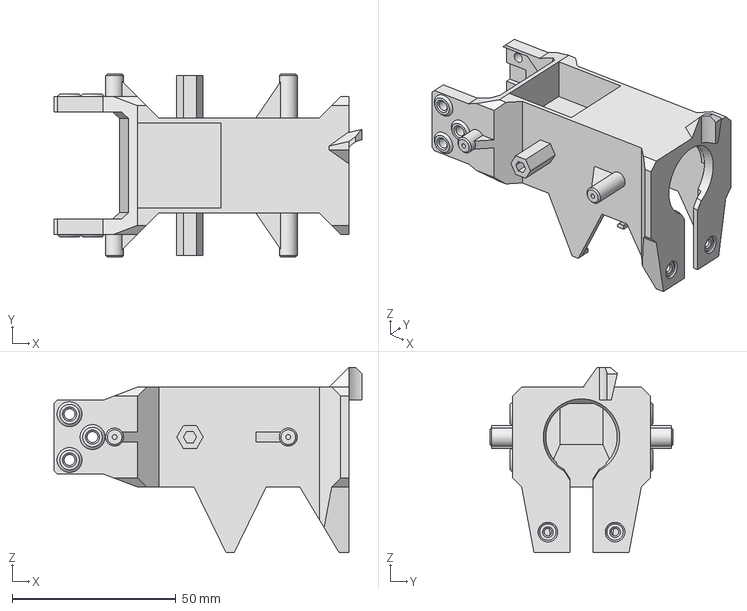
[picture p36: CAD file, 2026-10-17]
hardware/arm/follower/STEP/elrobot_common_parts/Joint 4.stp
94.0 x 56.0 x 56.5 mm
