AutoFAB-dev/Robot-Hardware/hardware/arm/follower/STEP/elrobot_common_parts/Joint 6 Shield.stp

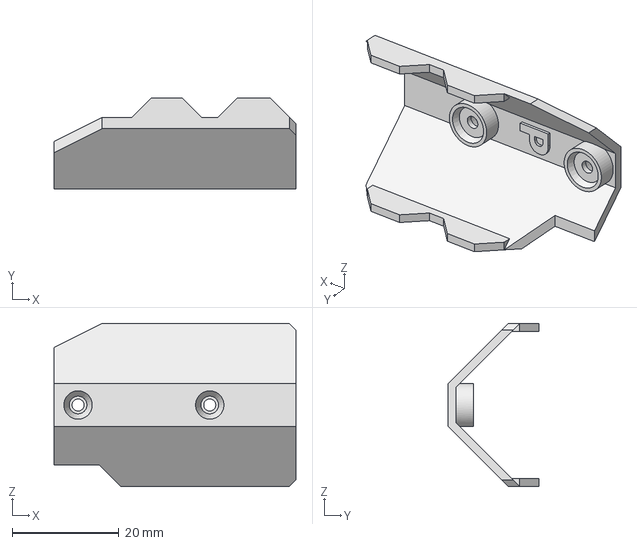
[picture p38: CAD file, 2026-10-17]
hardware/arm/follower/STEP/elrobot_common_parts/Joint 6 Shield.stp
45.3 x 17.0 x 30.5 mm
