AutoFAB-dev/Robot-Hardware/hardware/arm/follower/STEP/elrobot_common_parts/Base.stp

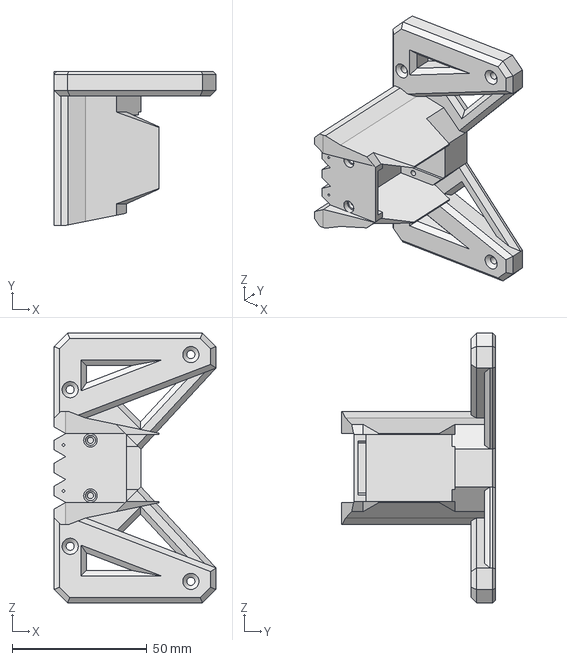
[picture p39: CAD file, 2026-10-17]
hardware/arm/follower/STEP/elrobot_common_parts/Base.stp
60.0 x 57.0 x 100.0 mm
