AutoFAB-dev/Robot-Hardware/hardware/arm/follower/STEP/elrobot_common_parts/Joint 2 Shield.stp

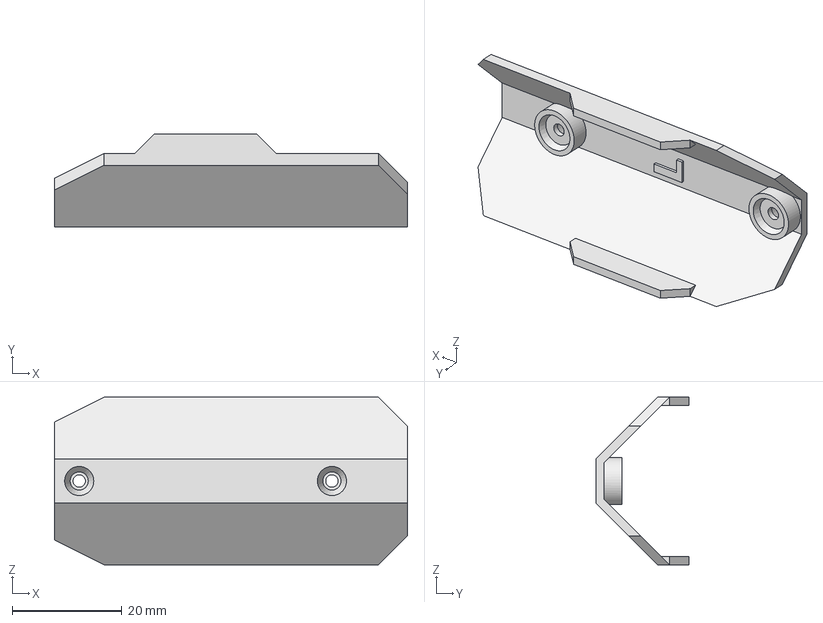
[picture p40: CAD file, 2026-10-17]
hardware/arm/follower/STEP/elrobot_common_parts/Joint 2 Shield.stp
64.2 x 17.0 x 30.5 mm
