AutoFAB-dev/Robot-Hardware/hardware/arm/follower/STEP/elrobot_common_parts/Joint 4 Shield.stp

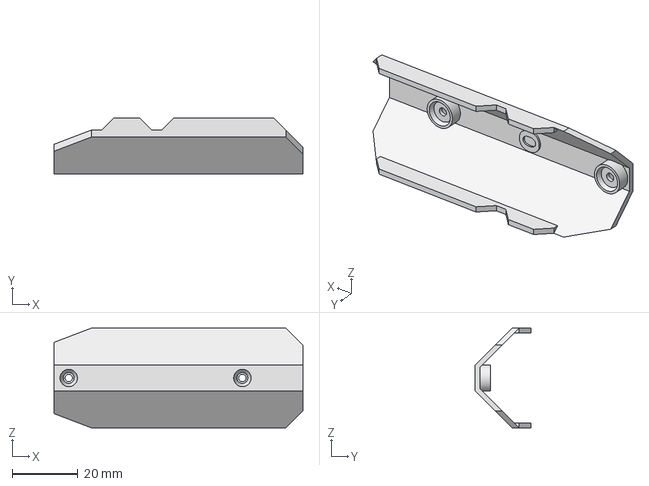
[picture p41: CAD file, 2026-10-17]
hardware/arm/follower/STEP/elrobot_common_parts/Joint 4 Shield.stp
76.0 x 17.0 x 30.5 mm
