AutoFAB-dev/Robot-Hardware/hardware/arm/follower/STEP/elrobot_common_parts/Joint 5.stp

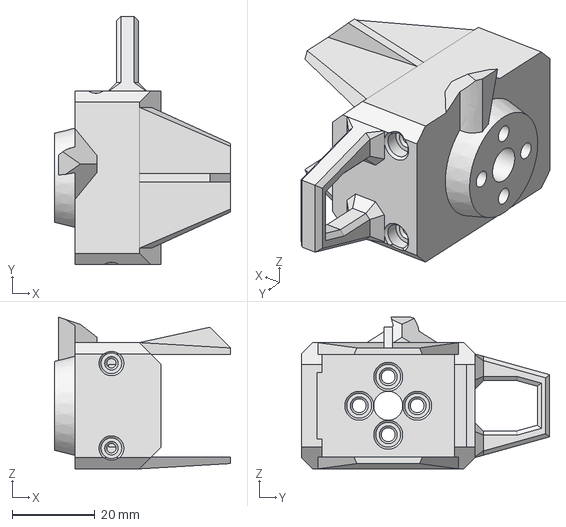
[picture p43: CAD file, 2026-10-17]
hardware/arm/follower/STEP/elrobot_common_parts/Joint 5.stp
42.5 x 60.0 x 36.7 mm
