AutoFAB-dev/Robot-Hardware/(list of files, cad)

Other CAD files:
hardware/arm/follower/print/basic/elrobot_follower_basic.3mf
hardware/cameras/print/ams/gripper_camera_mounts_ams.3mf
hardware/cameras/STEP/gripper_camera_mounts/CameraMount_square_27mm.stp
hardware/controller/print/basic/enclosure_for_waveshare_basic.3mf
hardware/arm/follower/STEP/elrobot_common_parts/Wiring_bracket.stp
hardware/arm/follower/STEP/elrobot_follower_parts/individual/Gripper_Jaw.stp
hardware/arm/follower/STL/elrobot_individual_parts/elrobot_follower_parts/Gripper Base Shield.stl
hardware/controller/print/basic/enclosure_for_seedstudio_basic.3mf
cad/elrobot/stl/CameraMount_regular.stl
hardware/arm/follower/STL/elrobot_individual_parts/elrobot_follower_parts/Gripper Base.stl
hardware/cameras/STEP/gripper_camera_mounts/CameraMount_square_34mm.stp
hardware/arm/follower/STEP/elrobot_common_parts/Joint 3 Shield Camera Side.stp
hardware/arm/follower/STL/elrobot_individual_parts/elrobot_common_parts/Joint 2.stl
hardware/arm/follower/STEP/elrobot_common_parts/Base Shield.stp
hardware/arm/follower/STL/elrobot_individual_parts/elrobot_common_parts/Joint 6.stl
hardware/arm/follower/STL/elrobot_individual_parts/elrobot_common_parts/Joint 4.stl
hardware/arm/follower/STL/elrobot_individual_parts/elrobot_common_parts/Joint 2 Shield.stl
hardware/arm/follower/STL/elrobot_individual_parts/elrobot_common_parts/Joint 3 Shield Drive Side.stl
hardware/arm/follower/STEP/elrobot_common_parts/Joint 3.stp
hardware/arm/follower/STL/elrobot_individual_parts/elrobot_common_parts/Base.stl
hardware/cameras/STL/gripper_camera_mounts/CameraMount_regular.stl
hardware/controller/STL/case_for_seedstudio/ss_enclosure_case.stl
hardware/controller/STL/case_for_seedstudio/ss_enclosure_lid.stl
hardware/controller/STL/case_for_waveshare/ws_enclosure_case.stl
hardware/controller/STL/case_for_waveshare/ws_enclosure_lid.stl
