AutoFAB-dev/Robot-Hardware/docs/setup/README.md

# Set up your cell

1. [What's in the box](01-whats-in-the-box.md)
2. [Unbox and check for damage](02-unboxing-and-damage-checks.md)
3. [Mount the arm and rail](03-mounting-arm-and-rail.md)
4. [Wiring, power, stop and cameras](04-wiring-power-stop-cameras.md)
5. [Flash, install, remote access](05-flash-install-remote-access.md)
6. [Link your printer](06-link-your-printer.md)
   After 5 and 6: [calibrate the cell](../calibration/) (servo IDs were local at assembly; arm and rail homing run after SSH, with [safety](../reference/safety.md) for powered motion)
7. [Ready check and handover](07-ready-check-and-handover.md)
