AutoFAB-dev/Robot-Hardware/docs/setup/02-unboxing-and-damage-checks.md

# 2. Unbox and check for damage

Open the box and look at every part before you mount anything.

**Safety:** Keep the 12 V supply unplugged. Support the arm so it cannot fall or fold under its own weight.

**TODO image:** open box with the arm supported and every part visible

## Look for
- Cracks in printed parts
- Bent rail, loose V-wheels, or a pinion that does not sit on the rack
- Cut or pinched cables
- A missing stop button or power supply
- A loose camera lens or broken USB plug

If the wrist camera and mount are packed separately, leave them off until [step 4](04-wiring-power-stop-cameras.md).

## If something is damaged
Stop. Take a photo (no faces, serial numbers, or network names) and see [Getting help](../getting-help.md). Do not power the arm.

**Back:** [1. What's in the box](01-whats-in-the-box.md)
**Next:** [3. Mount the arm and rail](03-mounting-arm-and-rail.md)
