AutoFAB-dev/Robot-Hardware/docs/setup/03-mounting-arm-and-rail.md

# 3. Mount the arm and rail

Put the cell next to the printer it will serve. The arm stays unpowered for this step.

**Safety:** Keep the 12 V supply unplugged. Leave clear space around the arm: **430 mm** reach from the base (ElRobot spec), plus the length of the rail. Watch for pinch points at the gripper and where the carriage meets the rack.

**TODO image:** rail clamped to a bench in front of a printer, arm supported, reach space marked

## Place the rail
1. Set the rail on a rigid bench or table in front of your printer(s).
2. Clamp both ends so the rail cannot slide or tip.
3. The carriage should roll the full length by hand. If it clicks or jumps, the pinion is not meshed with the rack — see [Troubleshooting](../troubleshooting.md).

## Support the arm
- The unpowered arm is limp. Hold it or rest it so it cannot slam down.
- With power still off, move each joint and the carriage through its full range. Cables should not snag. Leave slack at every joint.

## Scene camera spot
Pick a rigid place with a clear view of the whole print bed. You will fix the camera there in [step 4](04-wiring-power-stop-cameras.md). Don't put it where the arm will hit it.

**Back:** [2. Unbox and check for damage](02-unboxing-and-damage-checks.md)
**Next:** [4. Wiring, power, stop and cameras](04-wiring-power-stop-cameras.md)
