AutoFAB-dev/Robot-Hardware/(commit log)

2026-10-17 Initial hardware release
    First public AutoFAB cell hardware release: onboarding path, BOM buy links, and install script.
    [Base Shield.stl, Base Shield.stp, Base.stl, Base.stp, CameraMount_regular.stl, CameraMount_regular.stp, CameraMount_square_27mm.stl, CameraMount_square_27mm.stp]
2026-10-18 docs: add calibration guide for owners with hardware
    Document servo IDs and homing, arm profile files, and rail home from
    existing hardware docs plus the closed-software Calibrate/Settings
    flows. Mark camera, fiducial, and bed registration as TODO where no
    owner runbook exists. Link the new section after setup 05/06 and
    before the ready check.
