AutoFAB-dev/Robot-Hardware/(notices)

Notices in the files:
README.md:
Hardware: CERN-OHL-P-2.0
Docs: CC-BY-4.0
